KSeechan/Coil-Gun/README.md

# Coil-Gun
A single stage coil gun design that can be used for impact testing
