KSeechan/Coil-Gun/Poster/From Magnetic to Mechanical Electromagnetically Powered Impact System.pdf

# Testing Results

# Procedure

## Control System

# Future Work

# Design of Prototype

Power
Supply
(10 V)

Boost
Converter
(10 - 100 V)

Coil

Switch

Capacitor

Switch

## Linear Actuation & Power System

LCD screen
Toggle switch
Push button
Voltmeter

Armour systems need to be tested at ballistic velocities, requiring an impact velocity of 100m/s + The final design is a ceramic armour impact test that is suitable for limited lab space. The design is scalable, safe to operate, controllable, and repeatable.
Aim of the prototype is to prove the linear actuation and scalability of the design with a max. velocity of 10m/s

## Sensor System

2 sets of IR sensors

IR sensors are controlled by an Arduino Uno
Estimate average velocity

placed 25 cm apart

# From Magnetic to Mechanical: Electromagnetically Powered Impact System

## Y. T. Chen, N. Cristofaro, K. Seechan, V. Velikonja

# Objective

Coil has 400 turns and 12 layers of copper
Generates electromagnetic field to accelerate projectile

Maximum velocity recorded: 8.48 m/s at 50 V

Power Circuit

Toggle on switch
Wait for desired voltage on capacitor Toggle off switch
Press button to release projectile

1.
2.
3.
4.

Add MOSFET to improve release time of projectile Add more coil stages to increase projectile velocity Adjust coil geometry to increase efficiency
