KSeechan/Coil-Gun/Problem Statement/Problem Statement.pdf

Jasmine (Yu-Tung) Chen 1005024910 Nathalie Cristofaro 1004838009 Kevon Seechan 1004941708
Victoria Velikonja 1004861697

Capstone Group: ARL-MLS 1
Project: Design of Projectile Impact / Drop Test Rig for Damage Modelling Project Supervisor: Professor Kamran Behdinan
Client: ARL-MLS Lab

Problem Statement

Ceramics have been identified as a favourable material for the development of high protection, lightweight armour systems due to their low densities and high intrinsic strengths. However, ceramics possess the characteristic of brittleness, which means that they are likely to fracture and crack upon impact. Therefore, to fully explore the potential of ceramic use in armour systems, they must be tested in a controlled environment.

As such, the objective of this capstone project is to design and develop a projectile impact drop test rig for testing ceramics and other advanced lightweight multifunctional materials. A drop test can be defined as a test of the strength of a material by either dropping the material from a set height or dropping a projectile of specified weight and size onto the material [1]. The team aims to develop controlled, high-velocity drop testing methods. Figure 1 below depicts a non-functional drop test rig provided by the ARL-MLS Lab which will be retrofitted for this project.

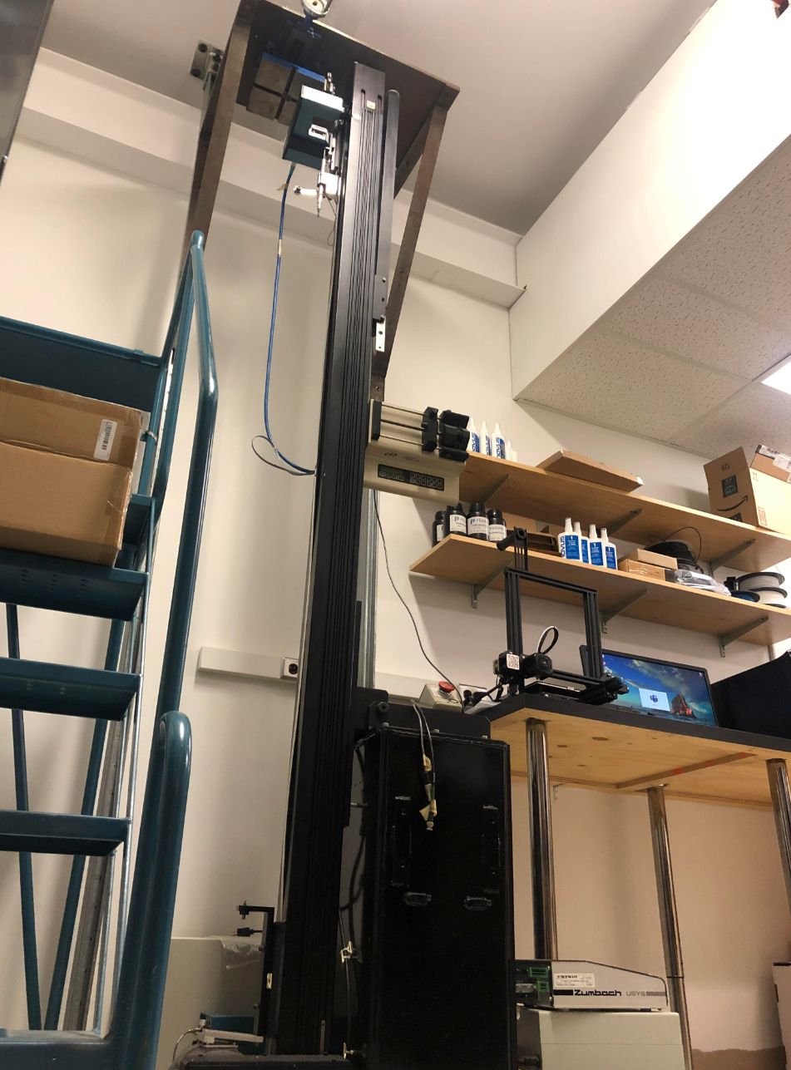
[picture p42: figure]

Figure 1. Current setup of the Drop Test Rig in the ARL-MLS Lab.

The current state of the art for testing ceramic armour systems utilises high-velocity ballistic impact experiments. These experiments involve using a gun to fire a projectile horizontally at a velocity between 40 m/s to 900 m/s into a test sample [2]. The gun is typically a multi-stage compressed air gun or a standard rifle. The sample is mounted at a specified distance away from the gun and high speed cameras are used to capture the instance of the impact. Sensors such as a laser velocity screen or an infrared emitted diode-photovoltaic cell are placed between the projectile and sample to capture velocity and impact data [2]. Figure 2 below shows the standard arrangement of a ballistic impact experiment.

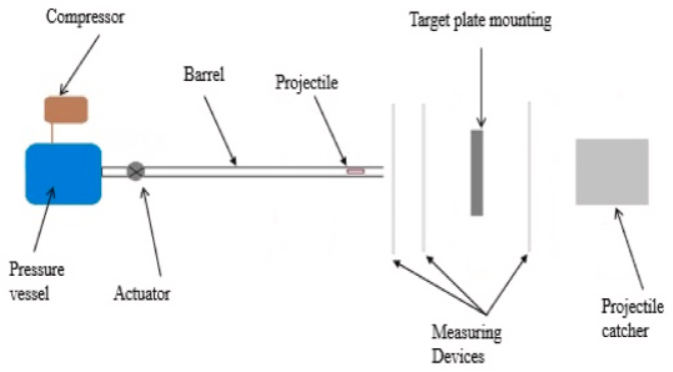
[picture p43: figure]

Figure 2. Standard Arrangement of a Ballistic Impact Experiment [2].

When designing the projectile impact drop test rig, the impact velocity, height of drop, weight of projectile, and safety standards need to be considered. With regards to the testing procedure, the type of test sample, method of control, and machine calibration are the influencing factors. As defined by the client, the distance of the drop test must be between 1.8 m to 2.5 m, and the impact velocity must be between 10 m/s to 15 m/s. Based on the client’s statement of need, the sample tested needs to be a fixed ceramic sample with a backing layer to simulate lightweight armour systems. Based on similar impact tests done on ceramic samples, metal, composite backing layers, or arranging mosaics made out of ceramic tiles and epoxy resin are all viable options for the team’s sample specimens [2]. Fragment-simulating projectile (FSP) has been accepted as a suitable representation on fragmentation for the armour testing community [3]. The most common FSP used to test body armour is the 17 gr FSP which weighs 1.10g [4]. For this experiment, the exact mass and shape will be determined by how the weight is dropped and how the ceramic sample is positioned.

When performing a high-velocity impact drop test, operators are to follow the ISO 45001 standard for safety, which outlines the requirements for an occupational health and safety management system [5]. In addition to the ISO safety standard, ISO 7965-2 outlines the procedure used when impact testing a filled sack made from thermoplastic flexible film, which can be similarly implemented for a ceramic impact test to verify a safe testing procedure [6].

The scope of this capstone project is to design and deliver a high-velocity impact test rig prototype at a level 4 rank on the Technology Readiness Level (TRL) scale. TRL 4 requires complete proof-of-concept work that validates the successful performance of a system that achieves the project requirements and applications [7]. TRL 4 demonstrations can consist of computer-based and/or simulated bench-top testing [7]. The design is to progress to TRL 4 over an eight-month period. As resources for this prototype design, an allocated budget of $500 and existing equipment/machinery, as seen in Figure 1, that can be salvaged or repurposed have been provided.

References

[1] “drop, n. : Oxford English Dictionary.” https://www.oed.com/view/Entry/57881?rskey=fQSvIb&result=1&isAdvanced=false#eid 6025433 (accessed Sep. 16, 2022).
[2] N. D. Andraskar, G. Tiwari, and M. D. Goel, “Impact response of ceramic structures - A review,” Ceram. Int., vol. 48, no. 19, pp. 27262–27279, Oct. 2022, doi: 10.1016/J.CERAMINT.2022.06.313.
[3] P. Gotts, “International ballistic and blast specifications and standards,” Light. Ballist. Compos. Mil. Law-Enforcement Appl. Second Ed., pp. 115–156, Jan. 2016, doi: 10.1016/B978-0-08-100406-7.00005-2.
[4] “NATO - STANAG 4164 - Test Procedures for Armour Perforation Tests of Anti-Armour
Ammunition | Engineering360.” https://standards.globalspec.com/std/531145/STANAG
4164 (accessed Sep. 16, 2022).
[5] OHSAS Project Group, “OHSAS 18002:2008 - Occupational health and safety management systems — Guidelines for the implementation of OHSAS 18001:2007 - ICS 03.100.01: 13.100,” Occup. Heal. Saf. Assess. Ser., p. 88, 2008.
[6] “ISO 7965-2:1993(en), Sacks — Drop test — Part 2: Sacks made from thermoplastic flexible film.” https://www.iso.org/obp/ui/#iso:std:iso:7965:-2:ed-1:v1:en (accessed Sep. 16, 2022).
[7] D. Clausing and M. Holmes, “Technology readiness,” Res. Technol. Manag., vol. 53, no. 4, pp. 52–59, 2010, doi: 10.1080/08956308.2010.11657640.
